AgitPOV/AgitPOVera/README.md

# AgitPOVera

* "Circuit" was designed with Eagle.
* "Code" is made for Arduino to be run on the "Agit POVera (ATmega168,internal 8Mhz)" hardware (see next bullet point).
** "Code\hardware" : please put the "hardware" folder in your Arduino sketchbook.
* "Software" is made for Processing.
