AgitPOV/AgitPOVera/circuit/BOM.xls

Part | Value | Package | Library | Description | Count | Manufacturer part number | Link
BATT_20MM1 |  | BATTCOM_20MM_PTH | SparkFun-Electromechanical | 20mm battery connector, https://www.sparkfun.com/products/783 | 1 | BS-7 (best guess) | http://www.digikey.ca/product-detail/en/BS-7/BS-7-ND/389447
C1 | 470pF | CAP-PTH-SMALLEZ | SparkFun-Passives | Capacitor | 1 | K471J15C0GF5TL2 | Digikey : http://www.digikey.ca/product-detail/en/K471J15C0GF5TL2/BC1021CT-ND/286643
 |  |  |  |  |  |  | ou : http://www.digikey.ca/product-detail/en/RCER71H471K0DBH03A/490-7547-1-ND/4277464
C2 | .1uF | CAP-PTH-SMALLEZ | SparkFun-Passives | Capacitor | 1 | C315C104M5U5TA | Digikey : http://www.digikey.ca/product-detail/en/C315C104M5U5TA/399-4151-ND/817927
C8 | 4.7uF | CAP-PTH-SMALLEZ | SparkFun-Passives | Capacitor | 1 | FK14X5R1E475K | Digikey : http://www.digikey.ca/product-detail/en/FK14X5R1E475K/445-8300-ND/2815230
HALL |  | 1X03 | SparkFun-Connectors | Hall sensor | 1 | A1120LUA-T | Digikey :http://www.digikey.ca/product-search/en?KeyWords=620-1330-ND&WT.z_header=search_go
IC1 | MEGA8-P | DIL28-3 | atmel | Chip | 1 | ATMEGA168A-PU | Digikey : http://www.digikey.ca/product-detail/en/ATMEGA168A-PU/ATMEGA168A-PU-ND/2271215
J1 | AVR_SPI_PRG_6NS | 2X3-NS | SparkFun-Connectors | ICSP Header | 1(2x3) | (1x36) PEC36SAAN | http://www.digikey.com/product-detail/en/PEC36SAAN/S1012E-36-ND/859153
LED2...LED13 |  | LED5MM | SparkFun-LED |  | 12 | 3474AN-R7DB-AHJB-PR-MS | http://www.digikey.ca/product-detail/en/3474AN-R7DB-AHJB-PR-MS/1080-1014-1-ND/2675505
R3,R5...R15 | 47 | 0204/7 | resistor | LED resistors | 12 | CFM14JT47R0 | http://www.digikey.com/product-detail/en/CFM14JT47R0/S47QCT-ND/2617762
R4 | 10k | 0204/7 | resistor | Pull-up resistor | 1 | CFM14JT10K0 | http://www.digikey.com/product-detail/en/CFM14JT10K0/S10KQCT-ND/2617659
S1 |  | SWITCH-SPDT | SparkFun-Electromechanical | On/Off switch, https://www.sparkfun.com/products/102 | 1 | EG1218 (best guess) | http://www.digikey.ca/product-detail/en/EG1218/EG1903-ND/101726
Battery |  |  |  | 20mm battery | 1 | CR2032 | http://www.digikey.ca/product-search/en/battery-products/batteries-non-rechargeable-primary/394467?k=P189-ND
