AgitPOV/AgitPOVera/circuit/Agit POVera rev 5.brd

## EAGLE design circuit/Agit POVera rev 5.brd (2015-05-13)

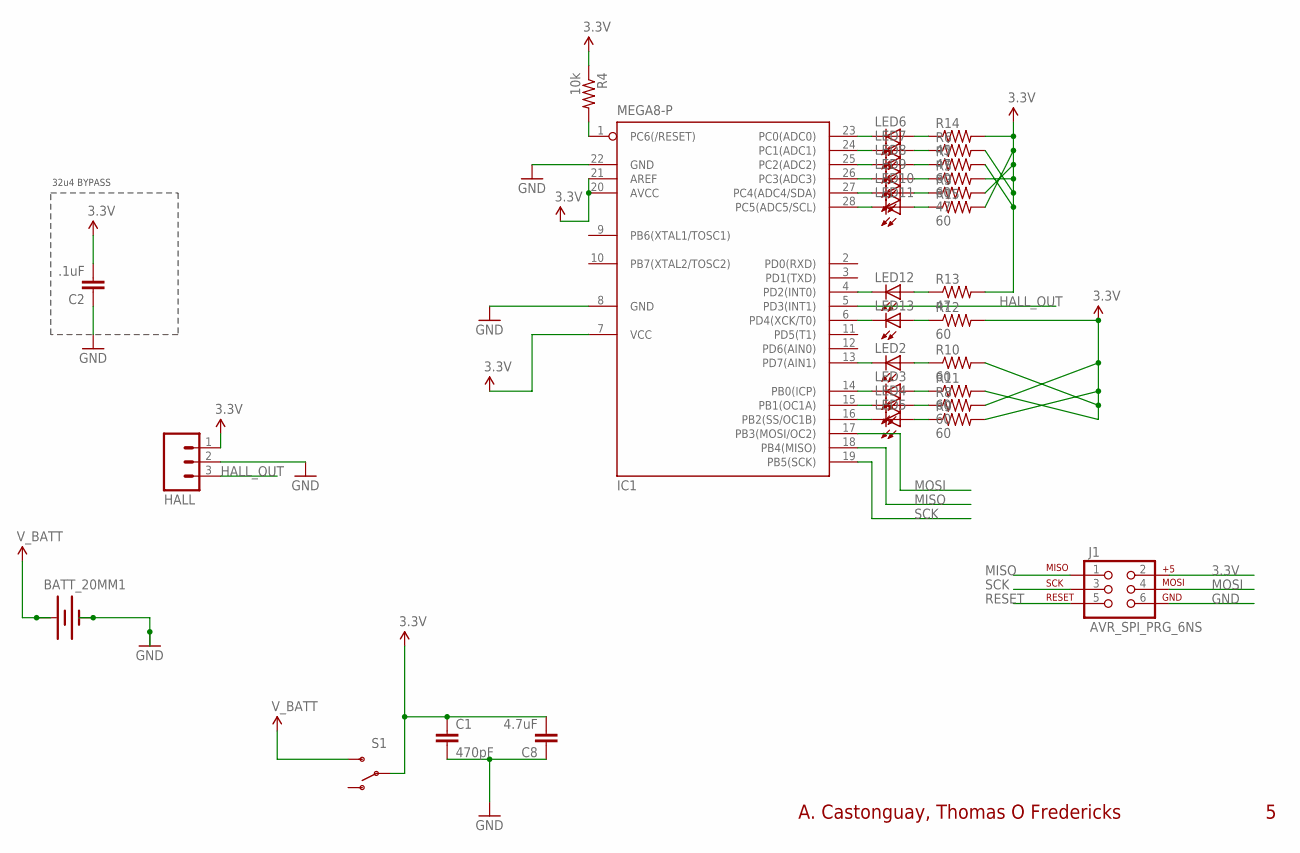
[picture p1: schematic Agit POVera rev 5.sch]

Parts:
BATT_20MM1: BATTERIE
C1: 470pF; CAP-PTH-SMALLEZ
C2: .1uF; CAP-PTH-SMALLEZ
C8: 4.7uF; CAP-PTH-SMALLEZ
HALL: M03PTH; 1X03
IC1: MEGA8-P; DIL28-3
J1: AVR_SPI_PRG_6NS; 2X3-NS
LED2, LED3, LED4, LED5, LED6, LED7, LED8, LED9, LED10, LED11, LED12, LED13: LED5MM
R3, R6, R13: 47; 0204/7
R4: 10k; 0204/7
R5, R7, R8, R9, R10, R11, R12, R15: 60; 0204/7
R14: 45; 0204/7
S1: SWITCH-SPDTPTH; SWITCH-SPDT

Connections:
3.3V: C1.1, C2.2, C8.2, HALL.1, IC1.7 (VCC), IC1.20 (AVCC), IC1.21 (AREF), J1.2, R3.2, R4.1, R5.2, R6.2, R7.2, R8.2, R9.2, R10.2, R11.2, R12.2, R13.2, R14.2, R15.2, S1.2
GND: BATT_20MM1.2 (-), C1.2, C2.1, C8.1, HALL.2, IC1.8 (GND), IC1.22 (GND), J1.6
HALL_OUT: HALL.3, IC1.5 (PD3(INT1))
LED2: IC1.13 (PD7(AIN1)), LED2.K (C)
LED3: IC1.14 (PB0(ICP)), LED3.K (C)
LED4: IC1.15 (PB1(OC1A)), LED4.K (C)
LED5: IC1.16 (PB2(SS/OC1B)), LED5.K (C)
LED6: IC1.23 (PC0(ADC0)), LED6.K (C)
LED7: IC1.24 (PC1(ADC1)), LED7.K (C)
LED8: IC1.25 (PC2(ADC2)), LED8.K (C)
LED9: IC1.26 (PC3(ADC3)), LED9.K (C)
LED10: IC1.27 (PC4(ADC4/SDA)), LED10.K (C)
LED11: IC1.28 (PC5(ADC5/SCL)), LED11.K (C)
LED12: IC1.4 (PD2(INT0)), LED12.K (C)
LED13: IC1.6 (PD4(XCK/T0)), LED13.K (C)
MISO: IC1.18 (PB4(MISO)), J1.1
MOSI: IC1.17 (PB3(MOSI/OC2)), J1.4
unnamed: LED7.A, R6.1
unnamed: LED12.A, R13.1
unnamed: LED13.A, R12.1
unnamed: LED3.A, R11.1
unnamed: LED2.A, R10.1
unnamed: LED5.A, R9.1
unnamed: LED4.A, R8.1
unnamed: LED10.A, R3.1
unnamed: LED11.A, R15.1
unnamed: LED6.A, R14.1
R7: LED8.A, R7.1
R9: LED9.A, R5.1
RESET: IC1.1 (PC6(/RESET)), J1.5, R4.2
SCK: IC1.19 (PB5(SCK)), J1.3
V_BATT: BATT_20MM1.1 (+), S1.3 (S)

Notes on the sheet:
32u4 BYPASS
A. Castonguay, Thomas O Fredericks

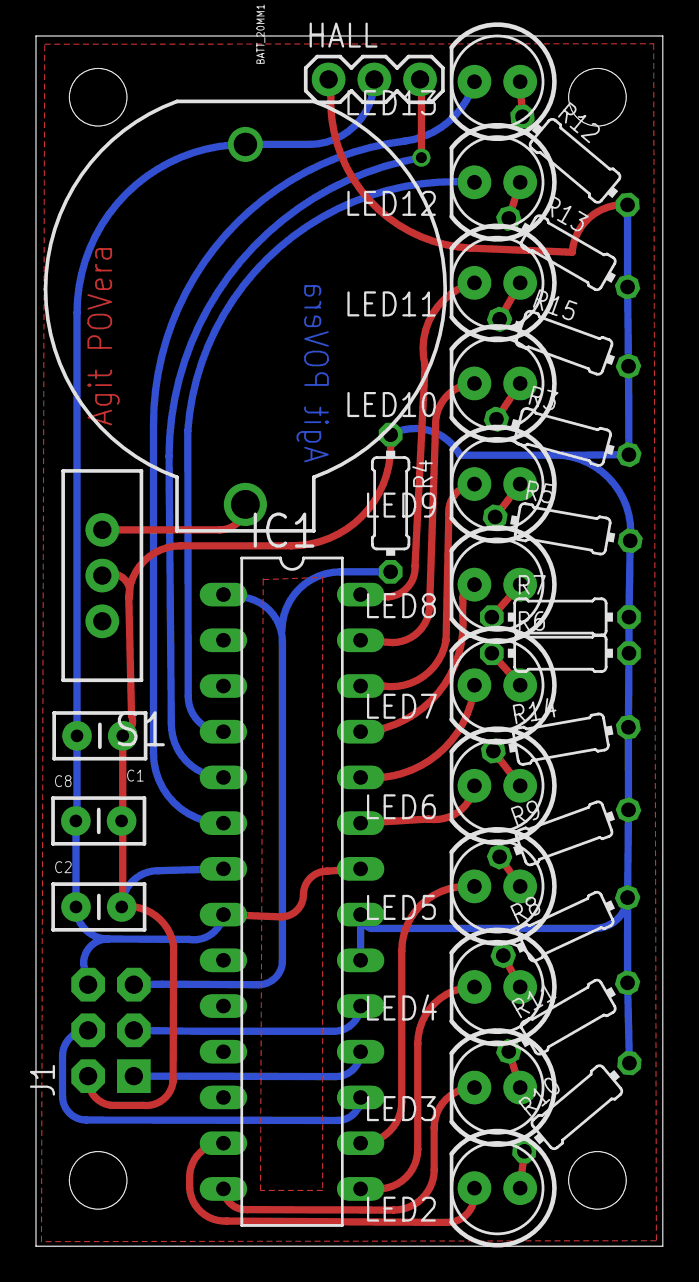
[picture p2: board Agit POVera rev 5.brd from above]

Board: 2 copper layers, 34.8 x 67.2 mm, 33 parts (0 on the bottom side), 32 nets.
