AgitPOV/AgitPOVera/circuit/build guide source/build guide inkscape rev 5.pdf

# Agit POVera

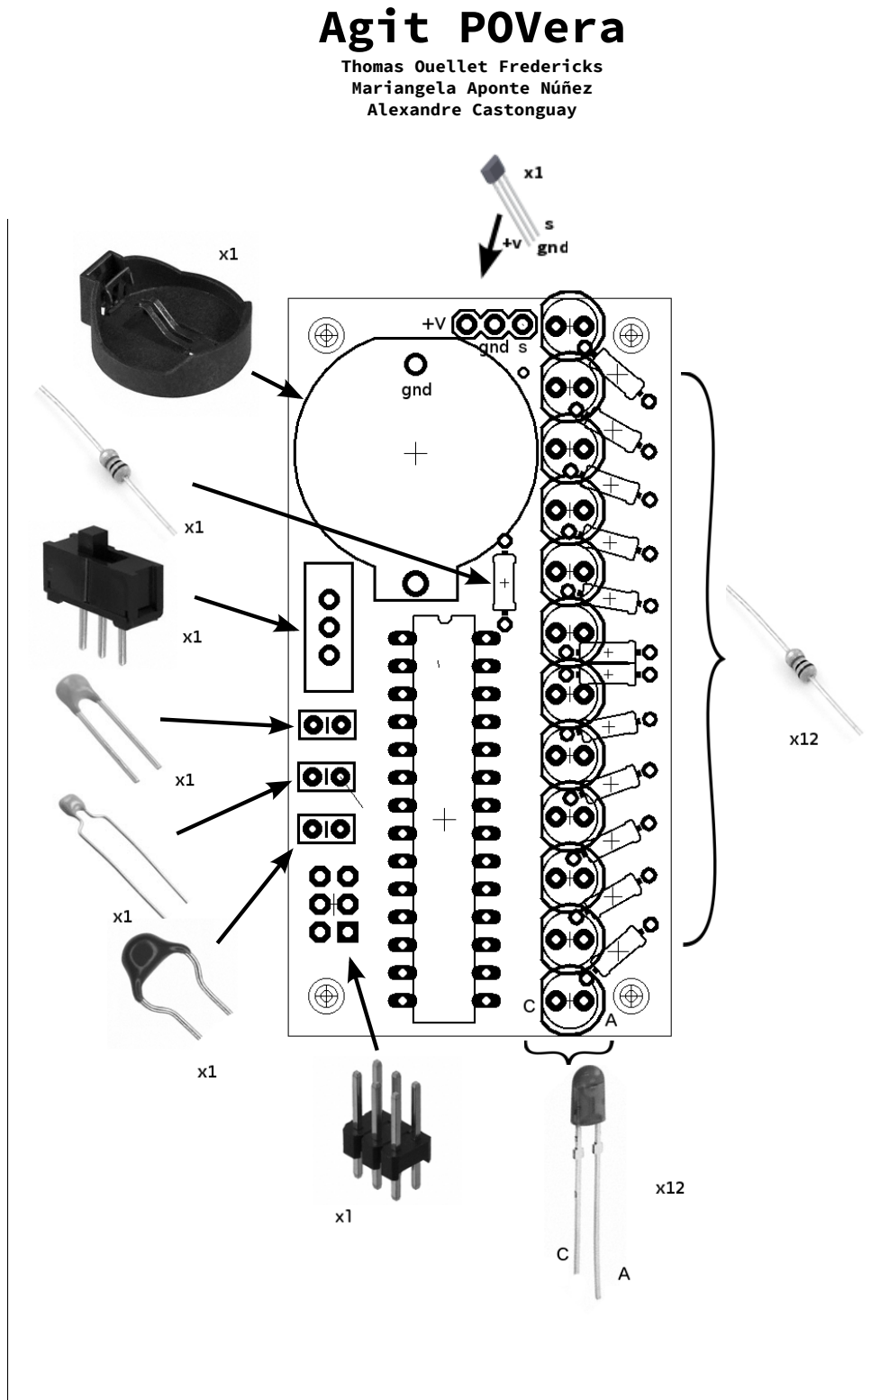
[picture p3: page 1]

Thomas Ouellet Fredericks
Mariangela Aponte Núñez
Alexandre Castonguay
