AgitPOV/AgitPOVera/(commit log)

2015-02-19 Original files
    [Agit POVera rev 3.brd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]
2015-02-19 Removed design folder
    [Angle de la fixation.skp, Conception de la fixation - Agit POVera.skp]
2015-02-19 First BOM
    [BOM.xls]
2015-02-19 No idea
    [BOM.xls]
2015-02-24 Updated LEDs in BOM
    [BOM.xls]
2015-02-24 Added code and software from Coyote
    [Agit POVera rev 3.sch, font_alex_keeling.csv]
2015-02-25 Updated Arduino Code for POVera
    [BOM.xls]
2015-02-26 Added hardware definitions for Arduino
2015-03-16 Fixed the code where the interval was not updating
    [AgitPOVera_Arduino.ino, povAcme.ino]
2015-05-06 Updated hardware so it works with Arduino 1.6
2015-05-13 Changes for rev 5
    Everything new is under ‘circuit’ :
    The build guide is updated;
    Removed the extra parts in the BOM;
    Added the new version of the .brd, .sch and the gerbers for people
    wanting to print more from board houses.
    [Agit POVera rev 3.GBL, Agit POVera rev 3.GBS, Agit POVera rev 3.GTL, Agit POVera rev 3.GTO, Agit POVera rev 3.GTS, Agit POVera rev 5.GBL, Agit POVera rev 5.GBO, Agit POVera rev 5.GBS]
